momina-rizwan/National_Engineering_Robotic_Contest_Robot/NERC_Robot_Module_3_Report.docx

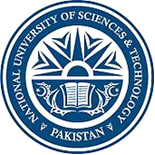
[picture p1: figure]
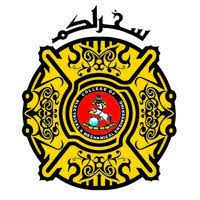
[picture p2: figure]

DEPARTMENT OF MECHATRONICS ENGINEERING

COLLEGE OF E&ME, NUST, RAWALPINDI

Mechatronics System Design

DE-45 MTS

Module III

SUBMITTED TO:

Ld Qasim

SUBMITTED BY:

NS Unzila Zeb (467557)

NS Momina Rizwan (473318)

NS Eman Khurram (457438)

GC Huzaifa Azam Khan (482905) Muhammad IbrahimNazir (482332)
NS Muhammad Ali Rayyan (461844)
GC Abdul Shakoor (482914)

# Submission Date: 30-4-26

# Module 1: Drive Mechanism, Sensors and Navigation Code

## 1.1 Drive Mechanism and Motor Specifications

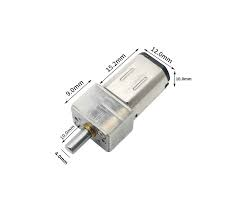
[picture p3: figure]
12mm Micro N20 Gear Motor 12V DC High ...

The robot uses a differential drive mechanism. Two independently driven rear wheels generate both translational and rotational motion, while the front castor wheel provides passive support and stability. This choice is suitable for line following because steering can be achieved by changing the relative speed of the left and right motors without using a separate steering linkage.

Parameter | Specification / Code Value | Purpose
Drive type | Differential drive, 2WD + castor | Independent left/right wheel speed control for line following and junction turns
Motor type | N20 DC gear motor, 12 V, 150 RPM | Compact geared motor with sufficient torque for arena motion
Wheel diameter | 40 mm | Provides 20 mm wheel radius for velocity and torque calculations
Track width | 120 mm | Used in differential-drive turning kinematics
Motor driver | IBT-2 H-bridge driver channels | Allows PWM forward/reverse control of each motor
Base speed | 90 PWM | Stable speed during normal PID line following
Max speed | 250 PWM | Upper speed limit used during fast forward segments
Turning speed | 100 PWM | Controlled turning speed used after junction decisions

Motor control is implemented using separate PWM pins for each direction on the left and right IBT-2 drivers. A positive PWM command drives a motor forward, a negative command reverses it, and zero PWM stops it. The right motor logic is intentionally reversed in code to compensate for the opposite physical orientation of the motor on the chassis.

Code:

#define L_RPWM 5
#define L_LPWM 4
#define L_REN 24
#define L_LEN 25
#define R_RPWM 8
#define R_LPWM 9
#define R_REN 28
#define R_LEN 29

void leftMotorForward(int pwm) {
pwm = constrain(pwm, -255, 255);
analogWrite(L_RPWM, pwm > 0 ? pwm : 0);
analogWrite(L_LPWM, pwm < 0 ? -pwm : 0);
}

void rightMotorForward(int pwm) {
pwm = constrain(pwm, -255, 255);
analogWrite(R_RPWM, pwm < 0 ? -pwm : 0);
analogWrite(R_LPWM, pwm > 0 ? pwm : 0);
}

void stopMotors() {
leftMotorForward(0);
rightMotorForward(0);
}

## 1.2 Mechanical/Kinematic Basis from Module 2

The mechanical report specifies a 120 mm track width, 40 mm wheel diameter, N20 12 V 150 RPM gear motors, a 6 mm steel shaft, and an acrylic PMMA chassis. With wheel radius r = 0.02 m and motor angular speed 15.71 rad/s, the calculated wheel speed is approximately 0.314 m/s. The differential drive equations used are:

v = (v_R + v_L) / 2
omega = (v_R - v_L) / L
v_wheel = omega_motor x r = 15.71 x 0.02 = 0.314 m/s

This supports the selected software speeds: normal line following is kept at a moderate BaseSpeed of 90 PWM for stability, while turns use SpeedTurn = 100 PWM so that the robot can rotate reliably without overshooting the black line.

## 1.3 QTR Sensor Code and Line Detection

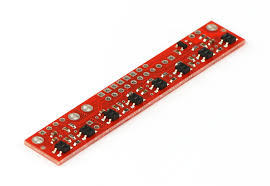
[picture p4: figure]
QTR-8A REFLECTANCE SENSOR MODULE , 8 ...

An 8-channel QTR analog reflectance sensor array is used for black line detection. The sensors are connected from A7 to A0 and calibrated during setup. The QTR library returns a weighted line position from 0 to 7000; the centre value is taken as 3500. A sensor reading above the line threshold indicates that the black line is present under at least one sensor.

Code:

const uint8_t SensorCount = 8;
uint16_t sensorValues[SensorCount];
#define LINE_THRESHOLD 600
#define QTR_CENTER_POSITION 3500

void setup() {
qtr.setTypeAnalog();
qtr.setSensorPins((const uint8_t[]){A7, A6, A5, A4, A3, A2, A1, A0}, SensorCount);
for (int i = 0; i < 50; i++) { qtr.calibrate(); delay(40); }
}

bool isLineDetected() {
for (int i = 0; i < SensorCount; i++)
if (sensorValues[i] > LINE_THRESHOLD) return true;
return false;
}

## 1.4 PID Line Following Code and Justification

The robot uses a PD controller during normal FOLLOW state. The proportional term responds to the current offset from the line centre, while the derivative term damps sudden changes in error. Integral control is intentionally not used because the line following task requires quick response and short-duration corrections rather than long-term accumulated error correction. This avoids integral wind-up at corners and junctions.

Code:

#define Kp 1
#define Kd 3
#define MaxSpeed 250
#define BaseSpeed 90

case FOLLOW: {
int error = (int)position - QTR_CENTER_POSITION;
int motorSpeed = (Kp * error) + (Kd * (error - lastError));
motorSpeed = constrain(motorSpeed, -50, 50);
lastError = error;
leftMotorForward (constrain(BaseSpeed + motorSpeed, 0, MaxSpeed));
rightMotorForward(constrain(BaseSpeed - motorSpeed, 0, MaxSpeed));
break;
}

PID term | Code value | Reason
Kp | 1 | Gives steering correction proportional to current line offset.
Kd | 3 | Reduces oscillation and helps the robot recover smoothly after curves/junctions.
Correction limit | -50 to +50 PWM | Prevents sudden motor commands that could throw the robot off the line.
BaseSpeed | 90 PWM | Chosen for stable tracking and reliable colour/junction detection.

## 1.5 Junction Counting and Lock Logic

External IR sensors on pins 30 and 31 detect junctions. Whenever either IR sensor detects a junction while the robot is in FOLLOW state and the junction lock is inactive, the junction counter is incremented. A lock prevents the same physical junction from being counted repeatedly while the robot is still crossing it.

Code:

#define IR_LEFT 30
#define IR_RIGHT 31

bool detectIRJunction() {
if (millis() < ignoreIRUntil) return false;
return (digitalRead(IR_LEFT) == HIGH || digitalRead(IR_RIGHT) == HIGH);
}

if (detectIRJunction() && !junctionLock && state == FOLLOW) {
junctionCount++;
junctionLock = true;
junctionLockTime = millis();
stopMotors();
}

The lock is released only after a minimum lock time and once the IR sensors no longer detect the junction. In some cases, waitQTRUnlock is used to ensure the robot has reacquired the black line before accepting another junction count.

## 1.6 CLR/TCS3200 Sensor Code for S1 Blue Face Detection

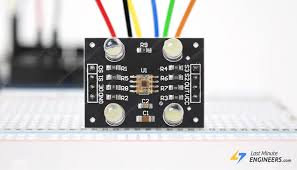
[picture p5: figure]
Interfacing TCS230/TCS3200 Color Sensor ...

The S1 blue face is detected using a TCS3200 colour sensor. The sensor output frequency is read for red, green and blue filter selections. Instead of comparing raw RGB values only, the code compares ratios R/B, G/B and R/G with calibrated blue and white thresholds. Ratio-based detection is more reliable because it reduces the effect of distance and light intensity variation.

Code:

ColorThresholds s1blueThreshold = {1.483, 1.441, 1.029};
ColorThresholds s1whiteThreshold = {1.113, 1.118, 0.996};
#define s1COLOR_TOLERANCE 0.2

void readColorSensor() {
long r_sum = 0, g_sum = 0, b_sum = 0;
for (int i = 0; i < 6; i++) {
r_sum += readColor(LOW, LOW );
g_sum += readColor(HIGH, HIGH);
b_sum += readColor(LOW, HIGH);
delay(5);
}
float r = r_sum / 6.0;
float g = g_sum / 6.0;
float b = b_sum / 6.0;
float rToB = r / b, gToB = g / b, rToG = r / g;

isBlueDetected = (
abs(rToB - s1blueThreshold.redToBlue) < (s1blueThreshold.redToBlue * s1COLOR_TOLERANCE) &&
abs(gToB - s1blueThreshold.greenToBlue) < (s1blueThreshold.greenToBlue * s1COLOR_TOLERANCE) &&
abs(rToG - s1blueThreshold.redToGreen) < (s1blueThreshold.redToGreen * s1COLOR_TOLERANCE)
);
}

## 1.7 Time Delays Used in the Code

Delay constant | Value | Purpose / justification
COLOR_SETTLE_DELAY | 150 ms | Allows the robot and colour sensor reading to settle at a junction before S1 scanning.
POST_JUNCTION_DELAY | 400 ms | Moves the robot slightly past the junction before executing a turn.
TURN_LEFT_DURATION | 400 ms | Timed left rotation until the robot is approximately aligned with the next black line.
TURN_RIGHT_DURATION | 520 ms | Timed right rotation; slightly longer because of motor orientation and chassis dynamics.
TURN_RIGHT_FORWARD_DELAY | 420 ms | Small forward motion before turning to improve turning centre and avoid detecting the same junction.
LEFT_DELAY_WAIT_DURATION | 6000 ms | Waiting period after blue target action; gives time for scanning/firing sequence and stability.
IR_IGNORE_DURATION | 150 ms | Temporarily ignores IR sensors immediately after special turns to prevent double counting.
LINE_SEARCH_TIMEOUT | 2000 ms | Safety timeout for reacquiring black line after a turn.
JUNCTION_LOCK_MIN_TIME | 600 ms | Minimum lock time to stop repeated junction increments.

## 1.8 Path Selection Code and State Machine

Path selection is implemented as a state machine. The robot remains in FOLLOW state for normal line following. At specific junction counts, the state changes to timed turn, delayed turn, target scanning, reverse/forward, or PARKED states. Flags such as blueSeenBefore9, blueSeenBefore11, blueSeenAtJunction6, blueSeenAtJunction8, blueSeenAtJunction10 and blueSeenAtJunction12 store where blue was detected and prevent repeated actions.

Code:

enum RobotState {
FOLLOW,
TURN_LEFT,
TURN_RIGHT,
TURN_RIGHT2,
LEFT_DELAY_RIGHT,
LEFT_DELAY_LEFT,
DELAY_RIGHT,
REVERSE_3_JUNCTIONS,
TURN_RIGHT_AFTER_REVERSE,
FORWARD_4_JUNCTIONS_NO_LINE,
STRAIGHT_UNTIL_JUNCTION,
TURN_RIGHT_AND_REVERSE,
PARKED
};

RobotState state = FOLLOW;

Junction / case | Detection condition | Robot action / selected path
case = 0 / default | No S1 blue face detected yet | Continue normal FOLLOW state and count junctions. At J9, if no earlier blue was found, turn left according to default route.
J3 | First programmed path decision | Turn left to enter the main arena path.
J6 | S1 blue detected at junction 6 | Set blueSeenAtJunction6, blueSeenBefore9 and blueSeenBefore11. Move slightly forward, enter LEFT_DELAY_RIGHT, scan/firing action, wait, turn right and return to line following.
J7 | Path correction point | Turn left normally, unless blue was detected at J12, in which case TURN_RIGHT2 is used.
J8 | S1 blue detected at junction 8 | Set blueSeenAtJunction8 and blue-before flags. Enter LEFT_DELAY_RIGHT and perform target scan/firing sequence.
J9 | Route selection based on previous detection | If blue was detected before J9, turn right. If blue was seen at J10/J12, continue forward. Otherwise, turn left by default.
J10 | S1 blue detected at junction 10 | Set blueSeenAtJunction10 and blueSeenBefore11. Decrease junction count by 2, enter LEFT_DELAY_LEFT, scan/fire, wait and rejoin path.
J11 | Fixed shooting/servo action point | Run junction11Action. If no blue was previously found before J11 and none at J12, turn left; otherwise continue straight.
J12 | S1 blue detected at junction 12 or prior blue handling | If earlier blue was found, turn left. If no earlier blue and blue is detected at J12, set blueSeenAtJunction12, decrease count by 6, enter LEFT_DELAY_LEFT and perform target action.
J13 | Terminal junction | Stop motors and enter PARKED state. Mission ends.

## 1.9 S1 Blue Face Scanning Table

The table below summarizes the intended S1 blue-face decision logic. The default case means that no blue face has been confirmed at the checked S1 junctions. Once blue is detected, the robot does not repeatedly scan the same route; it stores the detected junction in flags and executes the matching route toward the shooting/parking area.

Case | Blue face location | Flags set in code | Immediate action | Final route logic
0 | Default / no blue detected | No blue flags true | Continue line following and junction counting | Robot follows default path; at J9 it turns left if no blueSeenBefore9 flag is set.
1 | Blue at J6 | blueSeenAtJunction6 = true; blueSeenBefore9 = true; blueSeenBefore11 = true | LEFT_DELAY_RIGHT + blueDetectedAction() | Robot diverts at J6, scans S2-S5 target sensors, fires at blue squares, then turns back to the line and continues.
2 | Blue at J8 | blueSeenAtJunction8 = true; blueSeenBefore9 = true; blueSeenBefore11 = true | LEFT_DELAY_RIGHT + blueDetectedAction() | Robot reaches next decision with blue-before flags active, so J9 route changes to right turn instead of default left.
3 | Blue at J10 | blueSeenAtJunction10 = true; blueSeenBefore11 = true | junctionCount -= 2; LEFT_DELAY_LEFT + blueDetectedAction() | Robot corrects the junction count and follows the left-delay-left route to align with target/parking section.
4 | Blue at J12 | blueSeenAtJunction12 = true; blueSeenBefore11 = true | junctionCount -= 6; LEFT_DELAY_LEFT + blueDetectedAction() | Robot uses special route correction so that later J7 logic can choose TURN_RIGHT2 if required.
5 | Prior blue already detected before J12 | Any of J6/J8/J10/J12 flag true | At J12, direct TURN_LEFT | Prevents duplicate scanning and sends robot toward final path/parking.
6 | Mission end | junctionCount == 13 | PARKED | Motors stop permanently; task is complete.

# Module 2 Addition: Shooting Mechanism Code

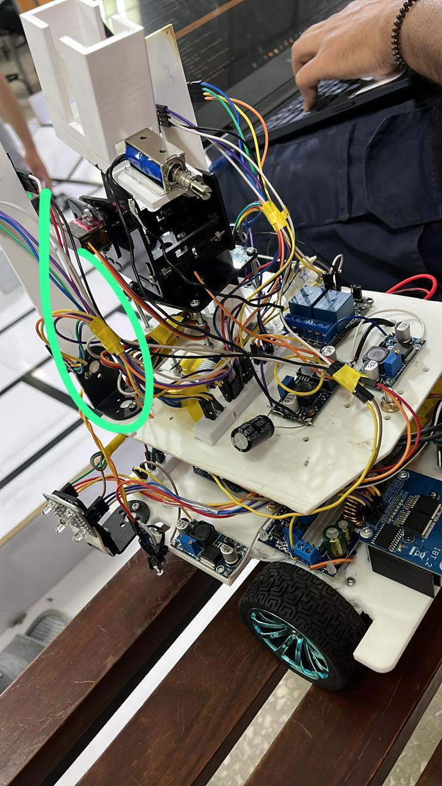
[picture p6: figure]

The Module 2 mechanical report already validates the differential drive base, shafts, motor brackets, QTR sensor bracket, wheels and acrylic chassis. For Module 3, the shooting mechanism is added as the functional end-effector. It consists of two servos and a relay-controlled firing actuator. Servo 1 controls vertical aim, Servo 2 controls horizontal/side aim, and the relay activates the firing mechanism for a short pulse.

Component | Pin / value | Function
Servo 1 | Pin 7 | Up/down aiming motion
Servo 2 | Pin 11 | Side aiming motion
Relay | Pin 26 | Turns firing actuator ON/OFF
S2 target angle | Servo2 = 120, Servo1 = top 100 | Aims at upper/side target S2
S3 target angle | Servo2 = 75, Servo1 = top 100 | Aims at upper/side target S3
S4 target angle | Servo2 = 120, Servo1 = bottom 70 | Aims at lower/side target S4
S5 target angle | Servo2 = 75, Servo1 = bottom 70 | Aims at lower/side target S5

Servo servo1; // Pin 7 (up/down)
Servo servo2; // Pin 11 (side)

#define SERVO1_PIN 7
#define SERVO2_PIN 11
#define RELAY_PIN 26

#define SERVO_ANGLE_S2 120
#define SERVO_ANGLE_S3 75
#define SERVO_ANGLE_S4 120
#define SERVO_ANGLE_S5 75
#define SERVO1_TOP_ANGLE 100
#define SERVO1_BOT_ANGLE 70

## 2.1 Servo and Relay Helper Functions

The servo helper function moves gradually from the current angle to the target angle. This reduces sudden jerks, improves aiming stability, and prevents the projectile direction from shifting due to servo vibration. The relay is active-low: LOW turns the firing circuit ON and HIGH turns it OFF.

void servoMoveTo(Servo &srv, int targetAngle, int stepDelay = 15) {
int current = srv.read();
if (current < targetAngle) {
for (int a = current; a <= targetAngle; a++) { srv.write(a); delay(stepDelay); }
} else {
for (int a = current; a >= targetAngle; a--) { srv.write(a); delay(stepDelay); }
}
}

void relayOn() { digitalWrite(RELAY_PIN, LOW); }
void relayOff() { digitalWrite(RELAY_PIN, HIGH); }

## 2.2 Target Square Colour Scanning S2-S5

Four extra TCS3200 sensors scan the target squares S2, S3, S4 and S5. These sensors share filter selection pins S0-S3 but have separate OUT and OE pins. Only one square sensor is enabled at a time, preventing signal conflict. Each sensor is averaged over multiple readings to improve reliability before deciding whether the square is blue.

#define SCAN_NUM_READINGS 3
#define SCAN_READ_DELAY 400

void disableAllSquare() {
digitalWrite(TCS2_OE, HIGH);
digitalWrite(TCS3_OE, HIGH);
digitalWrite(TCS4_OE, HIGH);
digitalWrite(TCS5_OE, HIGH);
}

void enableSquareSensor(int sensorNum) {
disableAllSquare();
switch (sensorNum) {
case 2: digitalWrite(TCS2_OE, LOW); break;
case 3: digitalWrite(TCS3_OE, LOW); break;
case 4: digitalWrite(TCS4_OE, LOW); break;
case 5: digitalWrite(TCS5_OE, LOW); break;
}
delay(10);
}

## 2.3 Aim and Fire Code

When a square sensor reports blue, the robot selects the corresponding pair of servo angles, waits briefly for mechanical settling, turns the relay on for 100 ms to fire, and then turns it off. This sequence is repeated for every blue target found from S2 to S5.

Code:

void aimAndFire(int sensorNum) {
int servo1Angle, servo2Angle;

switch (sensorNum) {
case 2: servo1Angle = SERVO1_TOP_ANGLE; servo2Angle = SERVO_ANGLE_S2; break;
case 3: servo1Angle = SERVO1_TOP_ANGLE; servo2Angle = SERVO_ANGLE_S3; break;
case 4: servo1Angle = SERVO1_BOT_ANGLE; servo2Angle = SERVO_ANGLE_S4; break;
case 5: servo1Angle = SERVO1_BOT_ANGLE; servo2Angle = SERVO_ANGLE_S5; break;
default: return;
}

servoMoveTo(servo1, servo1Angle);
servoMoveTo(servo2, servo2Angle);
delay(200);

relayOn();
delay(100);
relayOff();
delay(200);
}

## 2.4 Complete Scan-and-Fire Sequence

The scan-and-fire routine is called by blueDetectedAction() after the S1 blue face has been confirmed. The robot scans all four target sensors, reverses slightly to improve shooting distance, fires at every blue square, and finally returns both servos to neutral at 90 degrees.

Code:

void scanAndFireBlueTargets() {
bool sensorIsBlue[6] = {false};

sensorIsBlue[2] = scanSensorAveraged(TCS2_OUT, TCS2_OE, 2);
sensorIsBlue[3] = scanSensorAveraged(TCS3_OUT, TCS3_OE, 3);
sensorIsBlue[4] = scanSensorAveraged(TCS4_OUT, TCS4_OE, 4);
sensorIsBlue[5] = scanSensorAveraged(TCS5_OUT, TCS5_OE, 5);

disableAllSquare();

moveBackward(50);
delay(800);
stopMotors();
delay(200);

for (int s = 2; s <= 5; s++) {
if (sensorIsBlue[s]) {
aimAndFire(s);
}
}

servoMoveTo(servo1, 90);
servoMoveTo(servo2, 90);
}

## 2.5 Shooting Mechanism Justification

Design decision | Justification
Two-servo aiming | Separates vertical and horizontal aiming, allowing four target positions to be addressed using fixed calibrated angles.
Relay firing pulse | A 100 ms relay pulse provides repeatable firing while reducing heating and battery drain.
Averaged colour scan | Multiple readings reduce false blue detection caused by lighting variation or sensor noise.
Backward movement before firing | Improves distance and alignment before projectile release.
Neutral servo return | Reduces mechanical load and prepares the robot for a safe final state.

The robot uses a two-degree-of-freedom shooting mechanism consisting of two servo motors for aiming and a relay-controlled electromagnetic firing unit for launching the projectile. Servo 1 controls vertical motion while Servo 2 controls horizontal motion, allowing the robot to aim at different target boxes (S2–S5) using pre-calibrated angles. This design was selected because servo motors provide accurate positioning, low weight, and easy Arduino-based control. The firing actuator is triggered through a relay because the launcher requires higher current than the microcontroller can safely provide. A 3D printed guide and support structure is used to align the projectile and maintain repeatable firing direction. The complete mechanism is mounted on the upper part of the robot to improve line of sight, avoid interference with the drive and sensor systems, and maintain modularity. This design is justified because it is simple, low cost, lightweight, reliable, and well suited for fixed target positions in the arena.

# Module 2 Mechanical Integration Summary

The robot base is mechanically suitable for Module 3 because the Module 2 analysis shows high safety margins for the shafts, fasteners, motor bracket, QTR bracket, wheels and chassis. The lowest reported FOS is for the acrylic chassis, but it remains above the minimum design requirement. Therefore, the additional shooting module can be mounted without changing the drive system, provided the servos and relay assembly are mounted securely and their wiring does not interfere with the QTR sensor array or wheels.

Component | Material / specification | Reported FOS / result | Module 3 relevance
Shaft | 6 mm mild steel | FOS about 132 static | Safe under motor stall and direction changes.
M3 bolts | Steel fasteners | FOS about 243 in shear | Suitable for motor and bracket mounting.
Motor bracket | Steel bracket | FEA FOS about 65 | Supports motor reaction torque during turns.
QTR bracket | Steel L-bracket | FOS > 250 | Keeps line sensor stable near the ground.
Wheel rim | PC/ABS with rubber tyre | FOS about 46.7 | Supports traction and stall torque.
Chassis | 3 mm PMMA acrylic | FEA FOS about 19.7 | Main platform remains structurally safe for electronics and shooting module.

# Conclusion

Module 3 integrates the mechanical design from Module 2 with the complete autonomous navigation and shooting code. The robot uses differential drive motion, QTR-based PD line following, IR junction counting, TCS3200 S1 blue-face detection, state-machine path selection, and a two-servo relay-based firing mechanism. The logic ensures that the robot follows the default path until a blue face is detected, records the detection junction, selects the corresponding route, scans target squares S2-S5, fires only at blue targets, and parks at the final junction. The use of junction locks, line reacquisition timeouts, colour-settling delays, and averaged colour sensing improves reliability in the contest arena.

Theory of Machines | DE-45 MTS | SYN-C

NERC Robot Module 3 | Indigenous Line Following Robot
